jxmot/ESP8266-RCWL0516/(threads)

Thread 3 (2018-08-27):

Add README content for ESP-01

jxmot, 2018-08-27:
Add a new section with :
- Schematic
- Description
- Code changes

jxmot, 2020-09-16:
This issue will require:

- Build of ESP-01 version
- Testing of ESP-01 version
- Code modifications
- update README - pictures, text, diagrams(?)

NOTE: Create NEW branch for this work.

Thread 4 (2019-01-15):

Q: Why decoupling?

PJaros, 2019-01-15:
I'm planing to build a ESP8266 RCWL0516 but didn't plan to decouple it.

Did you build it that way because you got errournous results with a different build? Have you tried a simpler variation before you concluded to build it like that?

jxmot, 2019-01-15:
Hello,

Anytime I work with a module that is unknown to me I tend to play it safe. This is from previous experiences where a module _should_ have been safe but wasn't. This was the primary reason for building it with an opto-isolator.

The decision was also driven by the cost of replacing the NodeMCU vs the RCWL01516 (_if defective_). For example, the cost of the NodeMCU is about $9 and the RCWL0516 is about $2, and the opto-isolator was less than $1.

In addition it seems that the RCWL0516 can accept 4–28 VDC for it's power supply. There was a time where I was going to experiment with supplying it with 12VDC to see if that had any effect on range or behavior. In that situation the isolation is a necessity to keep from damaging the NodeMCU in case there's a failure of the RCWL0516.

A future version of the project may replace the NodeMCU with an ESP-01. In that version I will probably still use the opto-isolator, and supply the 3.3v to the ESP-01S from it's own regulator (5v to 3.3v).

**TIP :** When using pre-built circuits that can be operated _independent_ of support circuitry it's almost always a good idea to test them out before wiring them in. This was one of those situations. One of the RCWL0516 boards I bought was defective and output a constant 5v on the "OUT" pin.

chupocro, 2021-07-09:
You can use 3V3 output pin of RCWL-0516 for powering it with 3.3 V and in that case even failure wouldn't damage the ESP8266.

Thread 5 (2019-02-26):

Sensor too sensitive

guptamp, 2019-02-26:
Hello jxmot,

I followed your instructions and everything is working but it seems too good...
The sensor is even triggered in an empty unoccupied room about every 30-90s.
Do you have any idea how to decrease sensitivity?

jxmot, 2019-02-26:
Hello, first I recommend testing the sensor without connecting it to an MCU. You can power up the sensor independent of the rest of the circuit.

Take a look at the schematic in the README and replace the NTE3042 with a regular LED. Be sure that the polarity is correct and that the resistor is also present. After it's wired and powered up observe the LED. Does it exhibit the same behavior? If **yes** then the sensor is likely to be defective. if **no** then there might be an error in the code that is reading the device on your MCU.

You can also connect a volt meter in place of the LED.

There are several things to remember about the sensor :

1. It is sensitive, a very minor amount of movement within its _field_ can trigger a response.
2. It can detect presence from the back of the sensor, although not as sensitive as from the front.
3. It can also detect from the sides as well, although it's not as sensitive as the front and back sides.
4. The range of the sensor is very good from the front, I was able to easily detect a human at a distance of about 10 feet (3 meters).
5. At shorter distances from the sensor very minor changes within its _field_ can be detected.

I hope that helps!

Closed 2019-02-26.

Thread 6 (2019-05-12):

invert led on-off

webgps, 2019-05-12:
Dear James,

I tried to figure it out, how to invert when is the led on an when it's off, without luck.
So I want to led turn on when movement is detected, and turn on when de device is not detesting movements.
On ESP01 is everíthing working just fine with your code.

Please help.

Thanks in advance

jxmot, 2019-05-20:
Hello,

I apologize for not getting back to you sooner.... The problem isn't with the ESP-01. The issue is due to a bug in my code. As it turns out the ESP-01 and some other 8266 variants do not have an "on board" LED that can be toggled. When this project was originally developed I used a NodeMCU type, and it has an on board LED.

I plan on fixing the code issue, but until there here's what you can do to **disable** the LED code -

comment out lines: 98, 100, 118, 128, 137, and 163

That should cover you for polled and interrupt modes.

However, if you want to toggle an LED you could use a different I/O pin. If so then you would need to change all occurrences of "LED_BUILTIN" to the pin of your choice(lines 98, 100,147, and 163). And you may have to swap the definitions for LED_BUILTIN_ON and LED_BUILTIN_OFF. But that will depend on how you hook up the LED to the ESP-01.

Please note that LED_BUILTIN is defined in the Arduino header files.

Regards,
jim

webgps, 2019-06-06:
Hi Jim,

Are you sure about the line-numbers? :)

[https://github.com/jxmot/ESP8266-RCWL0516/blob/master/ESP8266-RCWL0516.ino](url)

jxmot, 2019-06-06:
Yes, I just rechecked them and commenting out those lines should disable any calls to operate the LED.

I also rechecked the lines for changing the LED to a different pin. They appear to be correct as well.

I haven't tested the changes on target because I'm planning on modifying the code to be conditionally compiled for the appropriate target. At this time I do not have an estimate to when that will occur.

jxmot, 2020-09-16:
Closed due to inactivity on this issue.

Closed 2020-09-16.

Thread 7 (2019-05-20):

Changes for ESP-01

jxmot, 2019-05-20:
Place #ifdef's around the "built-in LED" code. Disable it when not built for a NODEMCU type.

jxmot, 2019-05-20:
related to issue #3
