jxmot/ESP8266-RCWL0516/(commit log)

2017-11-14 reads sensor state by polling the input that it is connected to
2017-11-15 sketch will operate with polling or interrupts
2017-11-16 wip: README update, added schematic (draft)
2017-11-16 schematic: fixed, added pin numbers to opto
2017-11-16 schematic: minor change
2017-11-20 wip: README update, interrupts, added images (draft)
